EdgeCoil/cec-bridge/cec-bridge/cec-bridge/cec-bridge.kicad_pcb

## KiCad design cec-bridge/cec-bridge/cec-bridge.kicad_pcb (2026-11-02)

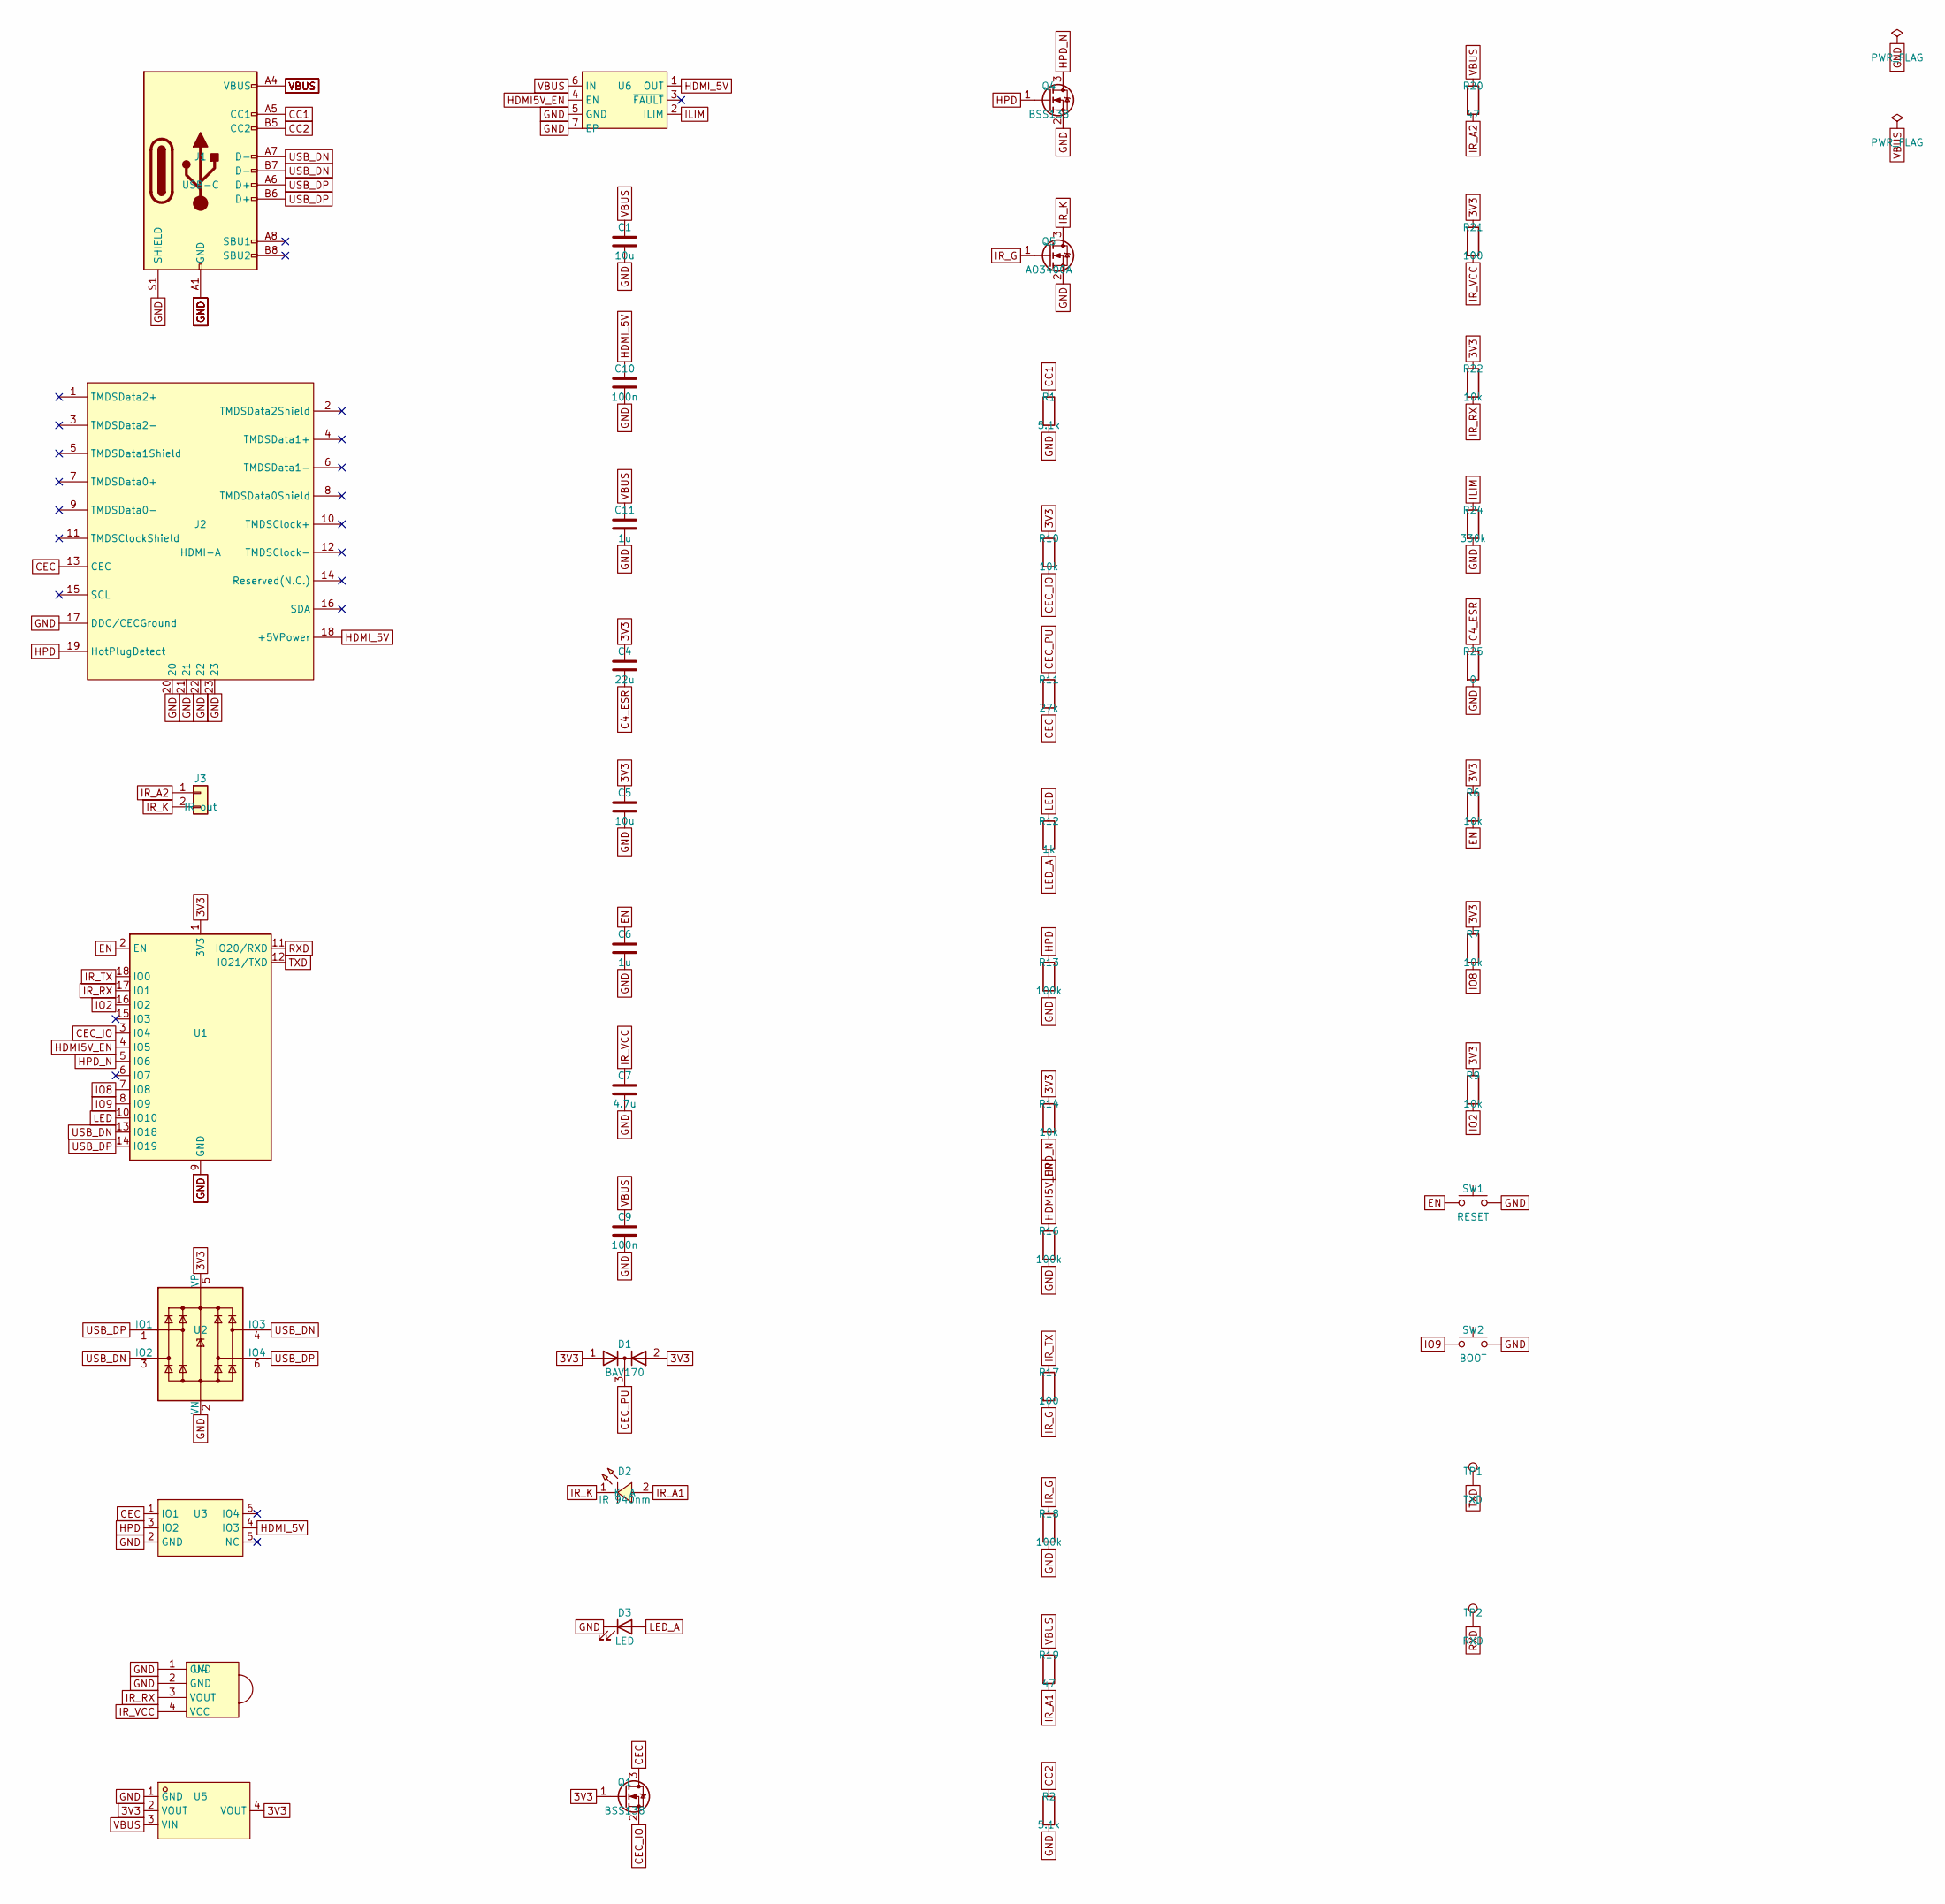
[picture p1: schematic cec-bridge.kicad_sch]

Parts:
C1: 10u; C_0805_2012Metric; LCSC C15850
C4: 22u; C_0805_2012Metric; LCSC C45783
C5: 10u; C_0603_1608Metric; LCSC C19702
C6, C11: 1u; C_0603_1608Metric; LCSC C15849
C7: 4.7u; C_0603_1608Metric; LCSC C19666
C9, C10: 100n; C_0603_1608Metric; LCSC C14663
D1: BAV170; SOT-23; MPN BAV170,215; LCSC C109309
D2: IR 940nm; LED-SMD_L3.5-W2.8_CZ2835; MPN P2835P1IRS7G12; LCSC C22466173
D3: LED; LED_0805_2012Metric; LCSC C84256
J1: USB-C; USB_C_Receptacle_HRO_TYPE-C-31-M-12; MPN HRO TYPE-C-31-M-12; LCSC C165948
J2: HDMI-A; HDMI-SMD_19P-P0.50-H-F; MPN HDMI-001 19PCBTP; LCSC C138388
J3: IR out; JST_PH_S2B-PH-SM4-TB_1x02-1MP_P2.00mm_Horizontal; MPN XYECONN XY-S2B-PH-SM4-TB; LCSC C54582899
Q1, Q4: BSS138; SOT-23; MPN BSS138LT1G; LCSC C82045
Q5: AO3400A; SOT-23; MPN AO3400A; LCSC C20917
R1, R2: 5.1k; R_0603_1608Metric; LCSC C23186
R6, R7, R9, R10, R14, R22: 10k; R_0603_1608Metric; LCSC C25804
R11: 27k; R_0603_1608Metric; LCSC C22967
R12: 1k; R_0603_1608Metric; LCSC C21190
R13, R16, R18: 100k; R_0603_1608Metric; LCSC C25803
R17, R21: 100; R_0603_1608Metric; LCSC C22775
R19, R20: 47; R_0805_2012Metric; LCSC C17714
R24: 330k; R_0603_1608Metric; LCSC C23137
R25: 0; R_0603_1608Metric; MPN 0603WAF0000T5E; LCSC C21189
SW1: RESET; SW_Push_1P1T_XKB_TS-1187A; MPN XKB TS-1187A-B-A-B; LCSC C318884
SW2: BOOT; SW_Push_1P1T_XKB_TS-1187A; MPN XKB TS-1187A-B-A-B; LCSC C318884
TP1: TXD; TestPoint_Pad_1.0x1.0mm
TP2: RXD; TestPoint_Pad_1.0x1.0mm
U1: ESP32-C3-WROOM-02-N4; ESP32-C3-WROOM-02; MPN ESP32-C3-WROOM-02-N4; LCSC C2934560
U2: SRV05-4; SOT-23-6; MPN SRV05-4-P-T7; LCSC C85364
U3: TPD4E1U06; SOT-23-6; MPN TPD4E1U06DBVR; LCSC C124691
U4: IRM-H638T; SENSOR-SMD_IRM-H638T-TR2-TL; MPN IRM-H638T/TR2; LCSC C91447
U5: LDL1117S33R; SOT-223-4_L6.5-W3.5-P2.30-LS7.0-BR; MPN LDL1117S33R; LCSC C435835
U6: TPS25200DRVT; WSON-6-1EP_2x2mm_P0.65mm_EP1x1.6mm; MPN TPS25200DRVT; LCSC C2653855

Connections:
3V3: C4.1, C5.1, D1.1 (A), D1.2 (A), Q1.1 (G), R6.1, R7.1, R9.1, R10.1, R14.1, R21.1, R22.1, U1.1 (3V3), U2.5 (VP), U5.2 (VOUT), U5.4 (VOUT)
C4_ESR: C4.2, R25.1
CC1: J1.A5 (CC1), R1.1
CC2: J1.B5 (CC2), R2.1
CEC: J2.13 (CEC), Q1.3 (D), R11.2, U3.1 (IO1)
CEC_IO: Q1.2 (S), R10.2, U1.3 (IO4)
CEC_PU: D1.3 (K), R11.1
EN: C6.1, R6.2, SW1.1, U1.2 (EN)
GND: C1.2, C5.2, C6.2, C7.2, C9.2, C10.2, C11.2, D3.1 (K), J1.A1 (GND), J1.A12 (GND), J1.B1 (GND), J1.B12 (GND), J1.S1 (SHIELD), J2.17 (DDC/CECGround), J2.20, J2.21, J2.22, J2.23, Q4.2 (S), Q5.2 (S), R1.2, R2.2, R13.2, R16.2, R18.2, R24.2, R25.2, SW1.2, SW2.2, U1.9 (GND), U1.19 (GND), U2.2 (VN), U3.2 (GND), U4.1 (GND), U4.2 (GND), U5.1 (GND), U6.5 (GND), U6.7 (EP)
HDMI5V_EN: R16.1, U1.4 (IO5), U6.4 (EN)
HDMI_5V: C10.1, J2.18 (+5VPower), U3.4 (IO3), U6.1 (OUT)
HPD: J2.19 (HotPlugDetect), Q4.1 (G), R13.1, U3.3 (IO2)
HPD_N: Q4.3 (D), R14.2, U1.5 (IO6)
ILIM: R24.1, U6.2 (ILIM)
IO2: R9.2, U1.16 (IO2)
IO8: R7.2, U1.7 (IO8)
IO9: SW2.1, U1.8 (IO9)
IR_A1: D2.2 (A), R19.2
IR_A2: J3.1, R20.2
IR_G: Q5.1 (G), R17.2, R18.1
IR_K: D2.1 (K), J3.2, Q5.3 (D)
IR_RX: R22.2, U1.17 (IO1), U4.3 (VOUT)
IR_TX: R17.1, U1.18 (IO0)
IR_VCC: C7.1, R21.2, U4.4 (VCC)
LED: R12.1, U1.10 (IO10)
LED_A: D3.2 (A), R12.2
RXD: TP2.1, U1.11 (IO20/RXD)
TXD: TP1.1, U1.12 (IO21/TXD)
USB_DN: J1.A7 (D-), J1.B7 (D-), U1.13 (IO18), U2.3 (IO2), U2.4 (IO3)
USB_DP: J1.A6 (D+), J1.B6 (D+), U1.14 (IO19), U2.1 (IO1), U2.6 (IO4)
VBUS: C1.1, C9.1, C11.1, J1.A4 (VBUS), J1.A9 (VBUS), J1.B4 (VBUS), J1.B9 (VBUS), R19.1, R20.1, U5.3 (VIN), U6.6 (IN)

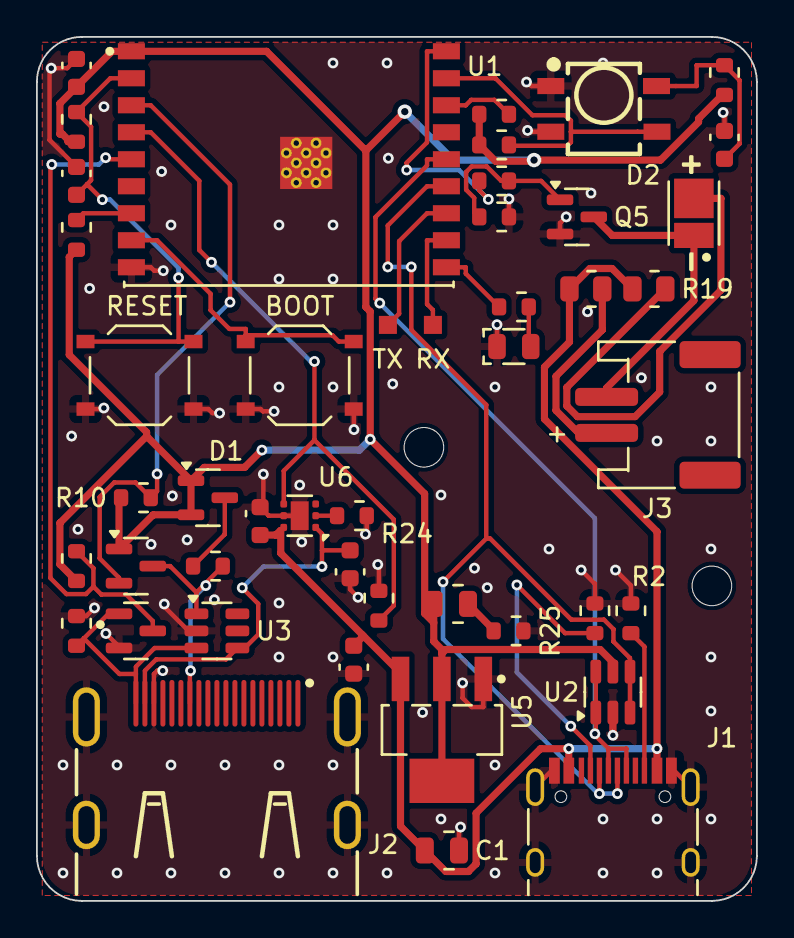
[picture p2: board cec-bridge.kicad_pcb from above]

Board: 2 copper layers, 40.0 x 48.0 mm, 48 parts (0 on the bottom side), 31 nets.

Other parts of the board:
H1, H2: M2; MountingHole_2.2mm_M2
