EdgeCoil/cec-bridge/(commit log)

2026-11-02 cec-bridge rev A: HDMI-CEC and IR bridge for Home Assistant
    Generated KiCad design with frozen routing, built with the vendored
    edgecoil-pcb toolkit. Reviewed and simulated; not yet ordered.
    [cec-bridge.kicad_pcb, cec-bridge.kicad_sch]
2026-11-02 CI: rebuild from source, prove it is the committed board, check fab outputs
    GitHub-hosted runner, KiCad 9.0.2 pinned by digest, frozen routing
    replayed. Includes a negative control (a via moved by 1 um must fail
    the comparison) and a check that every gerber timestamp is UTC.
